Jstn1321/Chua-Analog-Encryption/Simulations/Chua.asc

C1: cap; 10nF
C2: cap; 100nF
C3: cap; 100nF
C4: cap; .1µ
C5: cap; .1µ
R1: res; 220; tol=1
R2: res; 220; tol=1
R3: res; 2.2k
R4: res; 22k; tol=1
R5: res; 22k; tol=1
R6: res; 3.3k
R7: res; 100; tol=1
R8: res; 1k; tol=1
R9: res; 1k; tol=1
R10: res; 500; tol=1
R11: res; 2k; tol=1
U1: ADTL082
U2: ADTL082
U3: ADTL082
U4: ADTL082
U5: ADTL082
V1: voltage; -15v
V2: voltage; 15v
Named nets: 0, Chua_Out, +Vcc, -Vcc, Vcap1, Vcap2
.tran 0 10 0 .001
.step param X 100 2.5k 300
