Jstn1321/Chua-Analog-Encryption/(commit log)

2025-11-11 Fully updated schematic, fixed issues with schematic, added all footprints, pretty much finished pcb but need to finalize everything
    [ChuaCircuit.kicad_pcb, ChuaCircuit.kicad_sch]
2025-11-12 Added TL082 footprint along with the buffer circuit
    [ChuaCircuit.kicad_sch]
2025-11-24 Added all JLCPCB part ids to corresponding components
    [ChuaCircuit-B_Cu.gbl, ChuaCircuit-B_Mask.gbs, ChuaCircuit-B_Paste.gbp, ChuaCircuit-B_Silkscreen.gbo, ChuaCircuit-Edge_Cuts.gm1, ChuaCircuit-F_Cu.gtl, ChuaCircuit-F_Mask.gts, ChuaCircuit-F_Paste.gtp]
2025-11-24 Made CPL files
    [ChuaCircuit-bottom-pos.csv, ChuaCircuit-top-pos.csv]
2025-11-25 Added JLCPCB plugin and made new BOM/CPL files
    [ChuaCircuit.csv, ChuaCircuit.kicad_pcb, ChuaCircuit.kicad_sch, bom.csv, designators.csv, positions.csv]
2025-11-27 Rearraranged file directories and added LTSpice simulation of circuit
